trevordcampbell/open-source-hardware/README.md

# open-source-hardware
A collection of open source hardware
