trevordcampbell/open-source-hardware/pellet-dispensers/single-pellet-dispenser/individual-parts/ReadMe.md

# This directory contains all of the individual parts used in this assembly
