trevordcampbell/open-source-hardware/pellet-dispensers/single-pellet-dispenser/Pellet Dispenser.SLDASM

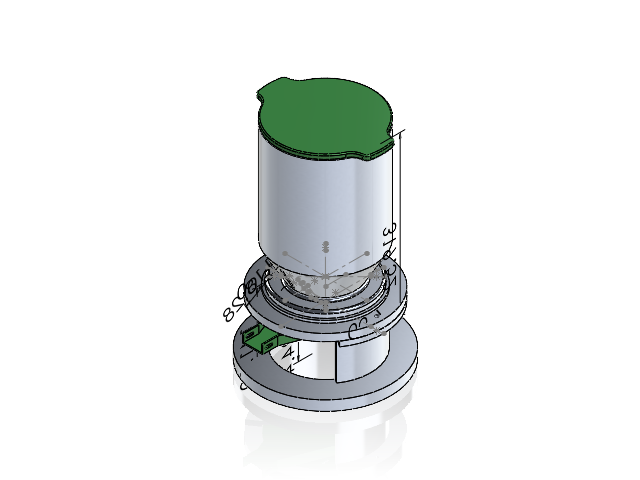
[picture p1: CAD file, 2024-03-22]
pellet-dispensers/single-pellet-dispenser/Pellet Dispenser.SLDASM
Hopper Tank
Hopper Tank Cover
Motor Mount
Motor Cover Plate
Rotating Plate
Pellet Slot Blocker
IR Beam Unit Mounting Plate
Pellet Outlet Track Mounting Plate
Pellet Outlet Track
Base Stand
