trevordcampbell/open-source-hardware/(list of files, cad)

Other CAD files:
pellet-dispensers/single-pellet-dispenser/individual-parts/Hopper Tank.SLDPRT
pellet-dispensers/single-pellet-dispenser/individual-parts/Rotating Plate.SLDPRT
pellet-dispensers/single-pellet-dispenser/individual-parts/Motor Cover Plate.SLDPRT
pellet-dispensers/single-pellet-dispenser/individual-parts/Pellet Outlet Track Mounting Plate.SLDPRT
pellet-dispensers/single-pellet-dispenser/individual-parts/Base Stand.SLDPRT
pellet-dispensers/single-pellet-dispenser/individual-parts/Motor Mount.SLDPRT
pellet-dispensers/single-pellet-dispenser/individual-parts/Hopper Tank Cover.SLDPRT
pellet-dispensers/single-pellet-dispenser/individual-parts/Pellet Slot Blocker.SLDPRT
pellet-dispensers/single-pellet-dispenser/individual-parts/IR Beam Unit Mounting Plate.SLDPRT
pellet-dispensers/single-pellet-dispenser/individual-parts/Pellet Outlet Track.SLDPRT
