trevordcampbell/open-source-hardware/(commit log)

2024-03-21 Added SW Assembly file for Pellet Dispenser
    [Pellet Dispenser.SLDASM]
2024-03-22 Add part files for each part used in assembly
    [Base Stand.SLDPRT, Hopper Tank Cover.SLDPRT, Hopper Tank.SLDPRT, IR Beam Unit Mounting Plate.SLDPRT, Motor Cover Plate.SLDPRT, Motor Mount.SLDPRT, Pellet Outlet Track Mounting Plate.SLDPRT, Pellet Outlet Track.SLDPRT]
2024-03-22 Add Updated SolidWorks Assembly File
    [Pellet Dispenser.SLDASM]
